al3xxli/party-plant/src/interface/wiring/PlantBand-UNO-R3-Wiring.png

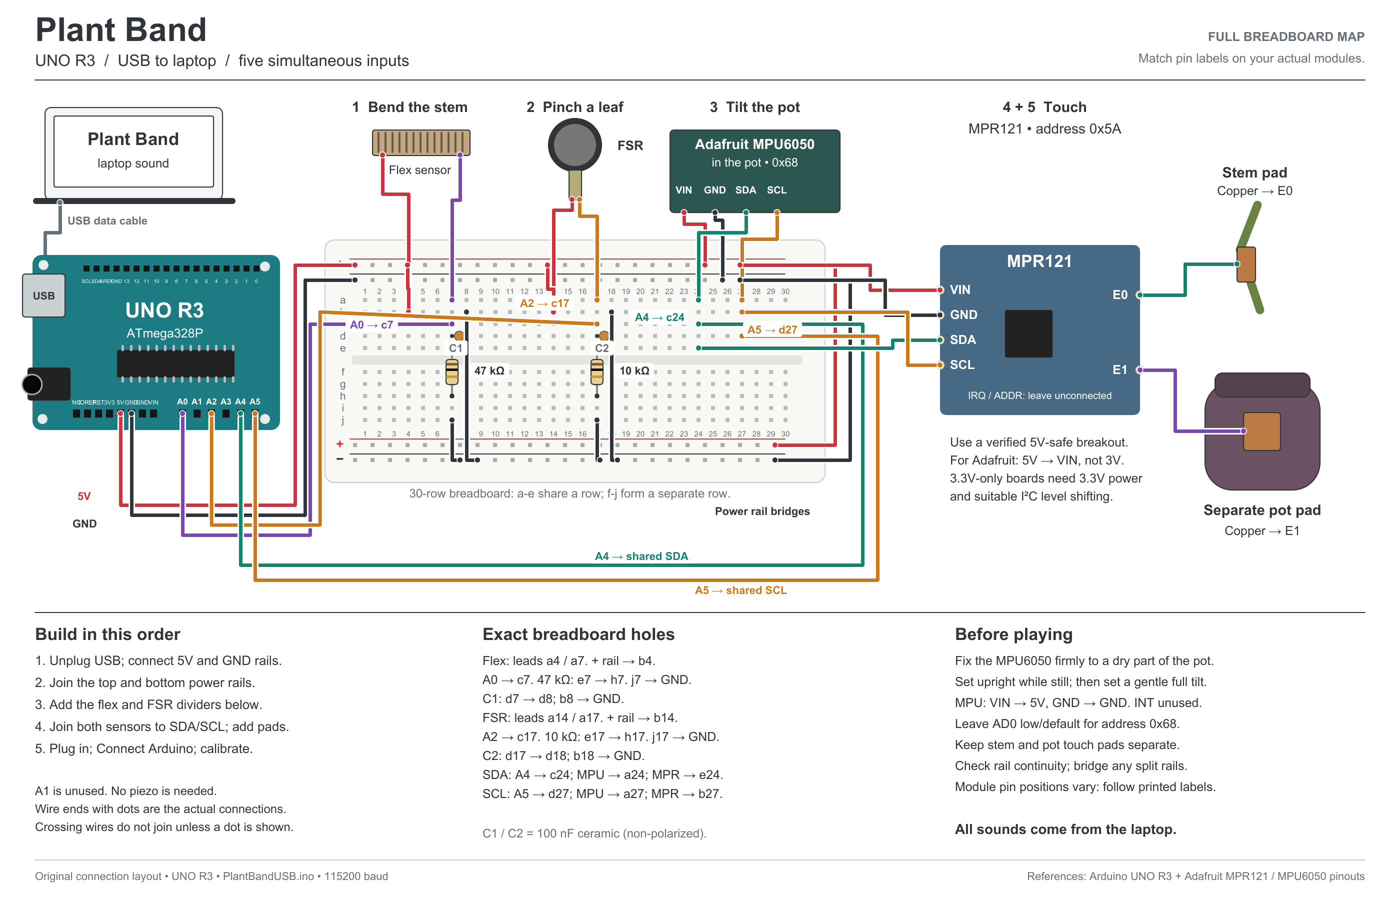
src/interface/wiring/PlantBand-UNO-R3-Wiring.png
